XXY608/esp32-mini-piano/第二版/README.md

# 第二版物料记录（设计中）

第二版正在研究机械轴琴键和新外壳，尚未完成整机设计与实物装配。本页是分版本的物料记录，不是定稿 BOM 或采购清单。第一版现有实物请看 [第一版物料清单](../第一版/BOM.md)。

## 计划沿用的第一版部件

第二版的设计目标是保留现有 PCB，并围绕现有主控、屏幕、电源、电池、功放和扬声器设计新结构。具体复用方式仍需按实物接口和装配空间核对；各部件记录见 [第一版 BOM](../第一版/BOM.md)。

## 第二版新增或变更

| 物料 | 计划数量 | 当前状态 |
|---|---:|---|
| 机械轴 | 10 个 | 对应 7 个音级键和 3 个修饰键；具体型号与实物配合待确认。项目曾讨论 CHERRY MX2A-71NN，仅为参考候选，尚无购买型号确认。 |
| 键帽 | 10 个 | 与所选机械轴的配合和形状待试配、定稿。 |
| 上盖及机械轴支承结构 | 待定 | 目标由外壳承托轴架，减少零碎件；结构和打印方式尚未定稿。 |
| 底壳及固定结构 | 待定 | PCB、接口、线束、电池与扬声器的固定和净空仍在研究。 |
| 按键连接线 | 按设计确定 | 机械轴通过导线与现有 PCB 电连接；规格、长度和走线待核实。 |
| 紧固件 | 待定 | 随新外壳及装配方案确定，不沿用第一版旧设计的数量作为定案。 |
| 充电母座固定结构 | 待定 | [局部试件](../充电座/README.md) 已有插拔和充电试配记录；整机安装仍待验证。 |

截至现有项目记录，机械轴尚未到货，轴体卡扣及键帽配合尚未实测；新外壳、接口和线束也尚未完成整机验证。后续确定实物型号、数量和装配方案后，再更新本表。
