XXY608/esp32-mini-piano/第一版/打印记录对应模型/README.md

# 第一版：打印记录对应的模型

这里收集第一版 R7b 修正件共 11 类 STL，每个结构件文件包含一件；另有一份十键排布文件。它们对应项目中的打印记录。作者反馈第一版大部件可以组装完成；打印记录没有逐件核实当前琴上零件的文件哈希，长期耐久也未验证。

## 文件

| 编号 | 部件 | 打印记录 |
|---|---|---|
| 01 | [键架](01_键架_打印1件_R7b.stl) | 打印历史有同名成功任务。作者曾反馈实物键架有问题，具体原因待确认。 |
| 05 | [上主体](05_上主体_打印1件_R7b.stl) | 打印历史有同名成功任务。 |
| 06-1 | [下U框](06-1_下U框_打印1件_R7b_已摆正.stl) | 五件合盘，经切片备份核对后，作者报告完成。 |
| 07 | [平底板](07_平底板_打印1件_R7b_已摆正.stl) | 打印历史有同名成功任务。 |
| 09 | [左侧件](09_左侧件_打印1件_R7b_已摆正.stl) | 五件合盘，经切片备份核对后，作者报告完成。 |
| 10 | [后面板](10_后面板_打印1件_R7b_已摆正.stl) | 打印历史有同名成功任务。 |
| 12 | [电池仓](12_电池仓_打印1件_R7b_已摆正.stl) | 五件合盘，经切片备份核对后，作者报告完成。 |
| 13 | [电池底盖](13_电池底盖_打印1件_R7b_已摆正.stl) | 五件合盘，经切片备份核对后，作者报告完成。 |
| 14 | [扬声器敞口仓](14_扬声器敞口仓_打印1件_R7b_已摆正.stl) | 扬声器三件合盘，经切片备份核对后，作者报告完成。 |
| 15 | [扬声器平顶板](15_扬声器平顶板_打印1件_R7b_已摆正.stl) | 扬声器三件合盘，经切片备份核对后，作者报告完成。 |
| 17 | [扬声器底盖](17_扬声器底盖_打印1件_R7b_已摆正.stl) | 扬声器三件合盘，经切片备份核对后，作者报告完成。 |

五件合盘包括 01、06-1、09、12、13；扬声器合盘包括 14、15、17。备份核对了模型形状和打印方向，完成状态来自作者报告。打印历史列表没有源文件哈希，单靠名称不能证明文件字节一致或确认装机位置。带“已摆正”的文件包含当时选定的打印方向；STL 不含切片参数。

## 琴键

[十键整套打印排布](10键整套_打印排布.stl) 是 R7g 版本，包含 7 个音级键和 3 个修饰键，共 10 个独立零件。打印历史有使用同名文件拆分出的部分琴键的成功记录，但记录不含源文件哈希，也不能确认当前装在琴上的各个键分别是哪一版。

作者确认此前讨论的止深片、定位销、脚、琴键面板、扬声器支柱和补充隔套等小部件均未用于现有实物，因此这里不收录这些小部件。琴键具体版本仍未逐一确认。
