XXY608/esp32-mini-piano/第一版/BOM.md

# 第一版物料清单（BOM）

本表按一台第一版现有实物整理。数量是单台用量，不是采购数量；“待核实”表示已有设计或采购记录，但尚不能确认当前实物的具体型号、数量或装配状态。第一版大部件可以组装完成；此前讨论的额外小部件未用于现有实物。

## 电子与供电

| 物料 | 单台数量 | 型号或规格 | 记录状态 |
|---|---:|---|---|
| 主控开发板 | 1 块 | ESP32-S3-WROOM-1-N16R8 | 实物及固件记录对应的开发板；[作者提供的商品链接](https://detail.tmall.com/item.htm?id=1084698494640&skuId=6311448758002) |
| TFT 显示屏 | 1 块 | 2.4 英寸、240 × 320，ST7789 兼容 | 实物和固件记录；[作者提供的商品链接](https://item.taobao.com/item.htm?id=800778518196&skuId=6106123487550) |
| 功放模块 | 1 块 | MAX98357A I2S 模块 | 项目用料记录；[作者提供的商品链接](https://item.taobao.com/item.htm?id=920099583982&skuId=5795705609446) |
| 扬声器 | 1 只 | 项目记录为 4 Ω、3 W | 已有记录；实际铭牌与接头以实物为准 |
| 电源模块 | 1 块 | DCP3512 四路降压模块 | 实物电源模块记录 |
| 锂电池包 | 1 组 | 标签记录为 12 V、2500 mAh，充电限制 12.6 V | 已有记录；保护板、接口具体型号待核实 |
| 主 PCB | 1 块 | 第一版定制双面板 | [订单 PCB 文件与图像](PCB/README.md) |
| 轻触开关 | 10 只 | TS-094-043250-D2，12 × 12 × 4.3 mm | 7 个音级键和 3 个修饰键；型号依据项目选型与采购记录，实装批次待核实 |
| 470 µF 电解电容 | 1 颗 | 16 V、ERG16V470M8X12 | 作者确认按原设计实践成功；数量和型号依据原设计及采购记录 |
| 100 nF 陶瓷电容 | 1 颗 | 50 V、DCS104Z26Y5VF6BL5A0 | 作者确认按原设计实践成功；数量和型号依据原设计及采购记录 |
| SD 存储 | 1 套 | 16 GB Class 10 MicroSD 卡及标准 SD 转接卡，使用显示屏卡槽 | 作者确认按原设计实践成功；[SD 相关链接 1](https://item.taobao.com/item.htm?id=1060089934296&skuId=6270390499712)、[SD 相关链接 2](https://detail.tmall.com/item.htm?id=614410938600) |
| 模块与 PCB 的连接 | — | 直接焊接 | 作者确认未使用此前列出的额外连接线、排针及排母连接模块；供电和扬声器自身线材按实物保留 |

商品链接由作者提供，保留了商品编号及原链接中的规格选项编号；商品页面未能独立核验具体选项，请打开后核对。其他物品可根据上表规格自行挑选。

## 结构与紧固件

| 物料 | 单台数量 | 说明 |
|---|---:|---|
| 3D 打印主体与仓体 | 按实物 | 上主体、底板、侧件、电池仓、扬声器仓等；对应的 [打印记录模型](打印记录对应模型/README.md) 可供查看，实装版本未逐件核实 |
| 琴键 | 10 个 | 7 个音级键、3 个修饰键；具体打印文件版本未逐一确认 |
| 琴键轴及紧固五金 | 按实物 | 有金属轴、螺丝等；实际规格和数量未清点，不能直接采用旧设计的完整五金表 |

充电母座局部试件是独立试配件，见 [充电座说明](../充电座/README.md)，不计入第一版整机 BOM。

## 资料依据

本表根据第一版实物照片、固件及 PCB 订单文件、项目既有用料和采购记录整理。已购或设计记录不等同于已安装；第一版琴键、紧固件等实装细节仍待核实；两种电容及 SD 存储按作者反馈记录。第二版另见 [第二版物料记录](../第二版/README.md)，不能把其中的机械轴和新外壳当作第一版用料。
