XXY608/esp32-mini-piano/充电座/12v锂电池母座固定3D模型.step

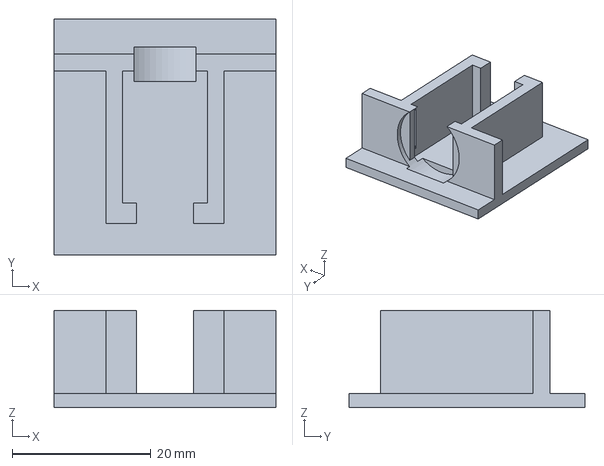
[picture p5: CAD file, 2026-10-30]
充电座/12v锂电池母座固定3D模型.step
32.0 x 34.0 x 14.0 mm
