XXY608/esp32-mini-piano/第一版/打印记录对应模型/10键整套_打印排布.stl

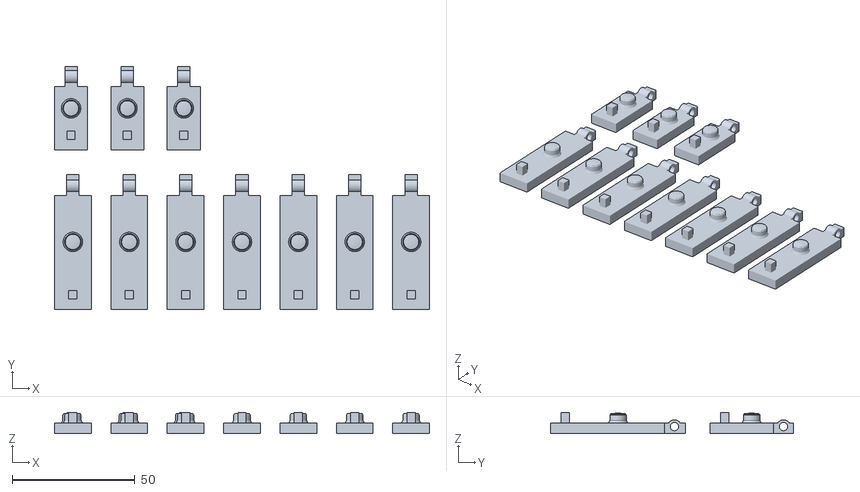
[picture p6: CAD file, 2026-10-30]
第一版/打印记录对应模型/10键整套_打印排布.stl
153.0 x 99.0 x 8.75
