XXY608/esp32-mini-piano/第一版/打印记录对应模型/17_扬声器底盖_打印1件_R7b_已摆正.stl

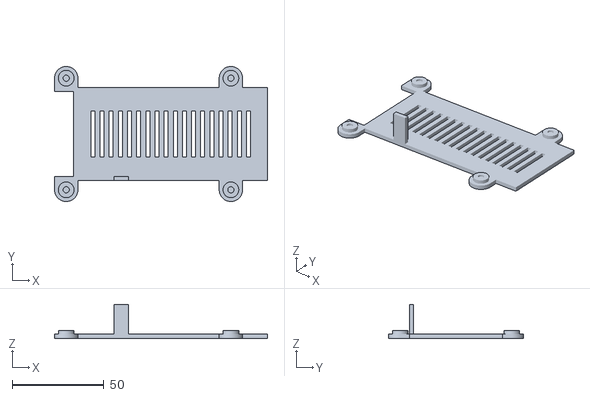
[picture p7: CAD file, 2026-10-30]
第一版/打印记录对应模型/17_扬声器底盖_打印1件_R7b_已摆正.stl
116.4 x 73.8 x 18.6
