XXY608/esp32-mini-piano/第一版/打印记录对应模型/12_电池仓_打印1件_R7b_已摆正.stl

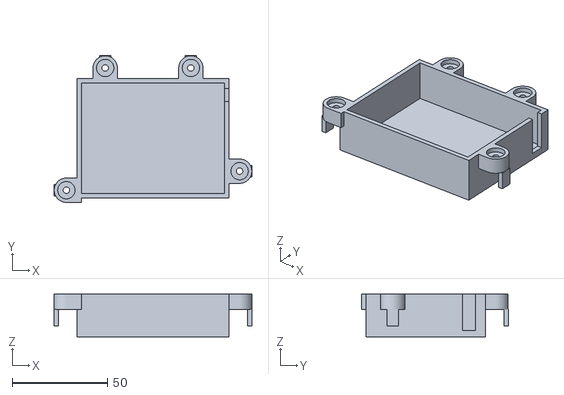
[picture p8: CAD file, 2026-10-30]
第一版/打印记录对应模型/12_电池仓_打印1件_R7b_已摆正.stl
104.0 x 77.1 x 22.4
