XXY608/esp32-mini-piano/第一版/打印记录对应模型/09_左侧件_打印1件_R7b_已摆正.stl

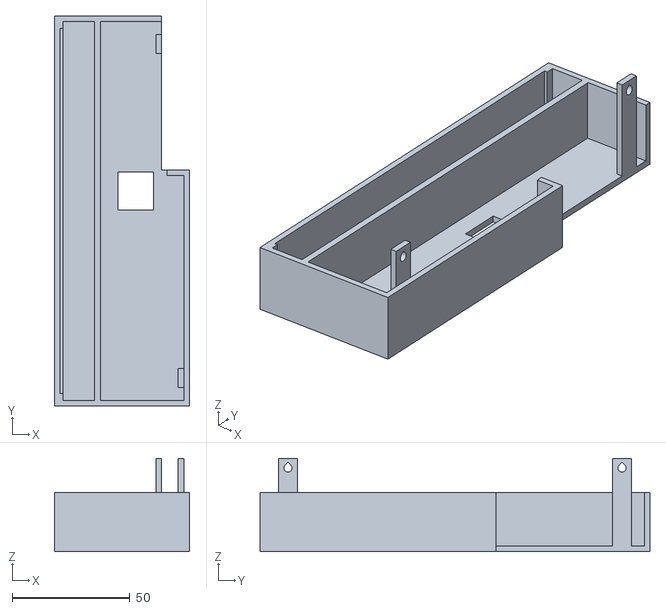
[picture p9: CAD file, 2026-10-30]
第一版/打印记录对应模型/09_左侧件_打印1件_R7b_已摆正.stl
57.4 x 165.8 x 39.6
