XXY608/esp32-mini-piano/第一版/打印记录对应模型/06-1_下U框_打印1件_R7b_已摆正.stl

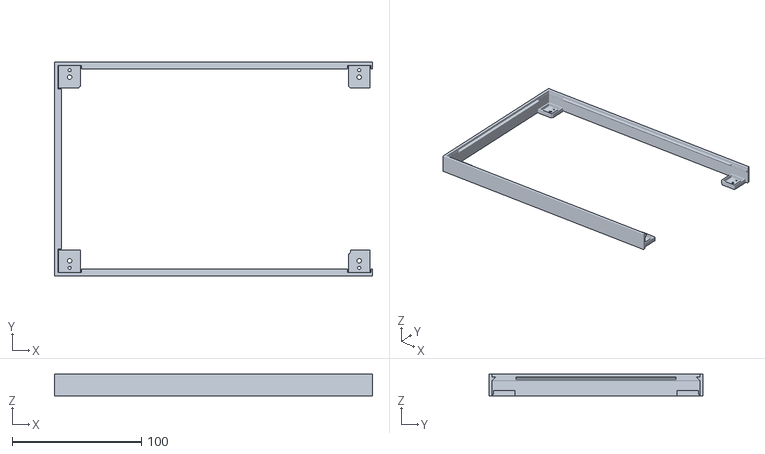
[picture p10: CAD file, 2026-10-30]
第一版/打印记录对应模型/06-1_下U框_打印1件_R7b_已摆正.stl
246.0 x 165.8 x 17.0
