XXY608/esp32-mini-piano/第一版/打印记录对应模型/13_电池底盖_打印1件_R7b_已摆正.stl

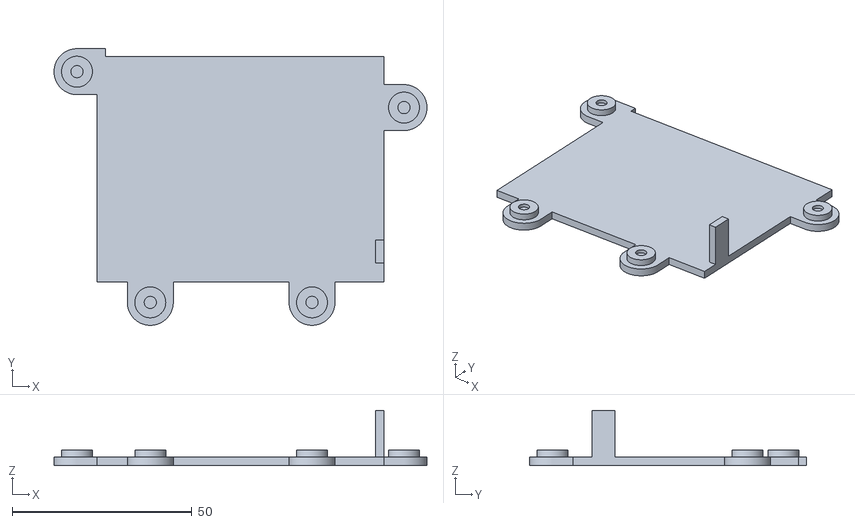
[picture p11: CAD file, 2026-10-30]
第一版/打印记录对应模型/13_电池底盖_打印1件_R7b_已摆正.stl
103.8 x 77.0 x 15.4
