XXY608/esp32-mini-piano/第一版/打印记录对应模型/15_扬声器平顶板_打印1件_R7b_已摆正.stl

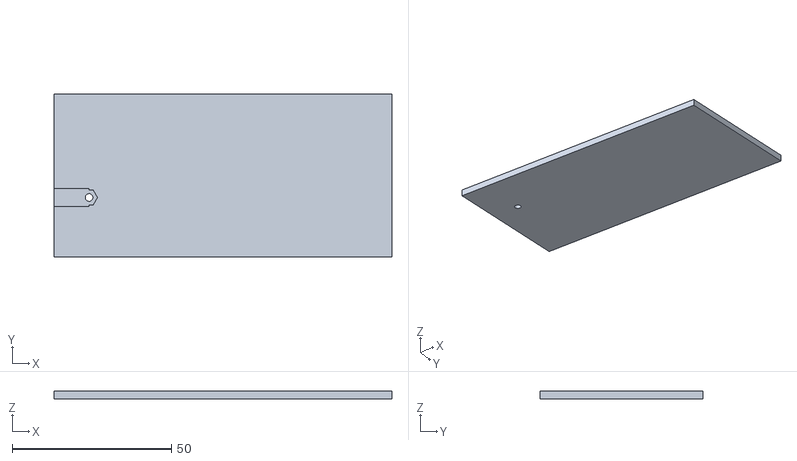
[picture p12: CAD file, 2026-10-30]
第一版/打印记录对应模型/15_扬声器平顶板_打印1件_R7b_已摆正.stl
106.0 x 51.0 x 2.40
