XXY608/esp32-mini-piano/第一版/打印记录对应模型/14_扬声器敞口仓_打印1件_R7b_已摆正.stl

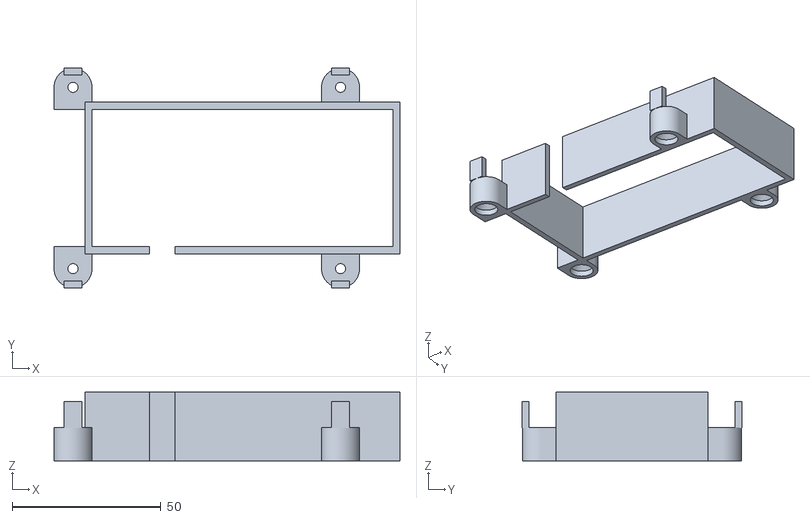
[picture p13: CAD file, 2026-10-30]
第一版/打印记录对应模型/14_扬声器敞口仓_打印1件_R7b_已摆正.stl
116.4 x 74.0 x 23.2
