XXY608/esp32-mini-piano/第一版/打印记录对应模型/07_平底板_打印1件_R7b_已摆正.stl

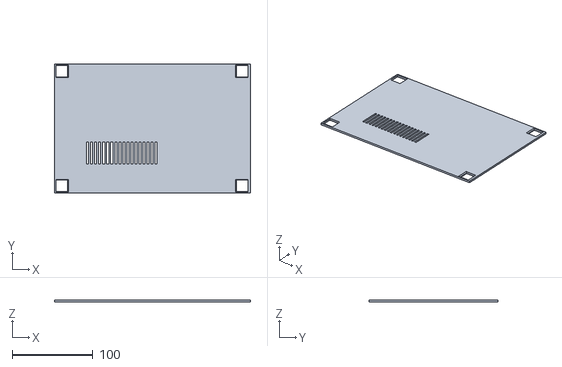
[picture p14: CAD file, 2026-10-30]
第一版/打印记录对应模型/07_平底板_打印1件_R7b_已摆正.stl
243.3 x 160.4 x 2.40
