XXY608/esp32-mini-piano/第一版/打印记录对应模型/10_后面板_打印1件_R7b_已摆正.stl

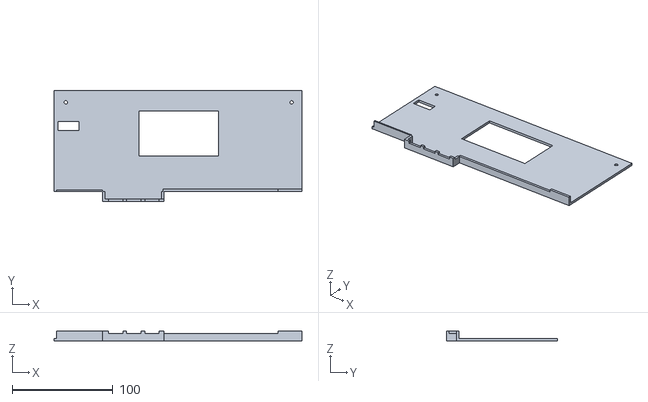
[picture p15: CAD file, 2026-10-30]
第一版/打印记录对应模型/10_后面板_打印1件_R7b_已摆正.stl
246.0 x 110.4 x 9.50
