XXY608/esp32-mini-piano/第一版/打印记录对应模型/05_上主体_打印1件_R7b.stl

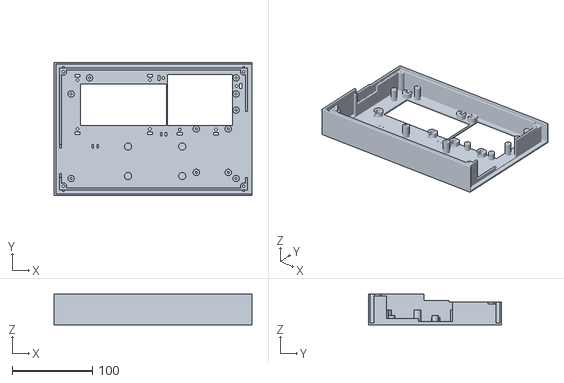
[picture p16: CAD file, 2026-10-30]
第一版/打印记录对应模型/05_上主体_打印1件_R7b.stl
246.0 x 165.8 x 38.0
