XXY608/esp32-mini-piano/第一版/打印记录对应模型/01_键架_打印1件_R7b.stl

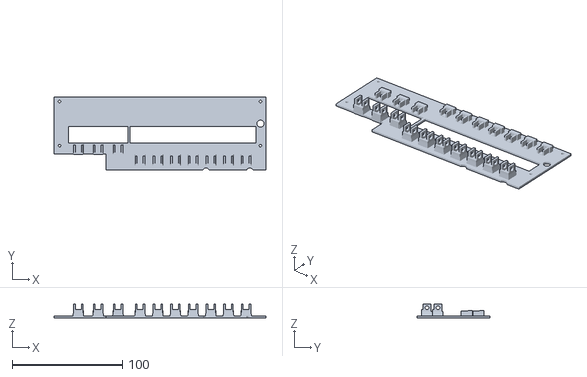
[picture p17: CAD file, 2026-10-30]
第一版/打印记录对应模型/01_键架_打印1件_R7b.stl
192.0 x 66.0 x 12.4
