XXY608/esp32-mini-piano/(list of files, cad)

Other CAD files:
充电座/12v锂电池母座固定3D模型.stl
