XXY608/esp32-mini-piano/(commit log)

2026-10-30 Add files via upload
    添加充电座试配模型
    [charge-fit-coupon-base.step, charge-fit-coupon-base.stl]
2026-10-30 Add 3D model for 12V lithium battery connector
    [12v锂电池母座固定3D模型.step]
2026-10-30 整理项目说明、充电座和第一版固件
    [partitions.csv]
2026-10-30 补充第一版打印记录对应模型
    [01_键架_打印1件_R7b.stl, 05_上主体_打印1件_R7b.stl, 07_平底板_打印1件_R7b_已摆正.stl, 10_后面板_打印1件_R7b_已摆正.stl]
2026-10-30 补充第一版PCB下单原始文件
    [Drill_NPTH_Through.DRL, Drill_PTH_Through.DRL, Drill_PTH_Through_Via.DRL, Gerber_BoardOutlineLayer.GKO, Gerber_BottomLayer.GBL, Gerber_BottomSilkscreenLayer.GBO, Gerber_BottomSolderMaskLayer.GBS, Gerber_TopLayer.GTL]
2026-10-30 调整PCB说明
2026-10-30 补充第一版已报告打印的结构件
    [06-1_下U框_打印1件_R7b_已摆正.stl, 09_左侧件_打印1件_R7b_已摆正.stl, 12_电池仓_打印1件_R7b_已摆正.stl, 13_电池底盖_打印1件_R7b_已摆正.stl, 14_扬声器敞口仓_打印1件_R7b_已摆正.stl, 15_扬声器平顶板_打印1件_R7b_已摆正.stl, 17_扬声器底盖_打印1件_R7b_已摆正.stl]
2026-10-30 补充打印记录对应的十键排布模型
    [10键整套_打印排布.stl]
2026-10-30 更新第一版实物装配说明
2026-10-30 整理充电座文件目录
    [12v锂电池母座固定3D模型.step, 12v锂电池母座固定3D模型.stl]
2026-10-30 完善第一版与充电座图文介绍
2026-10-30 将第一版实物照片调整为横向
2026-10-30 更新第一版横向照片路径
2026-10-30 分别整理第一版与第二版物料记录
2026-10-30 按实物反馈修正第一版物料清单
2026-10-30 为第一版物料清单补充商品链接
